AppleJuiceIzy/sony-a7iv-tec-version1/images/DSC08813.jpg

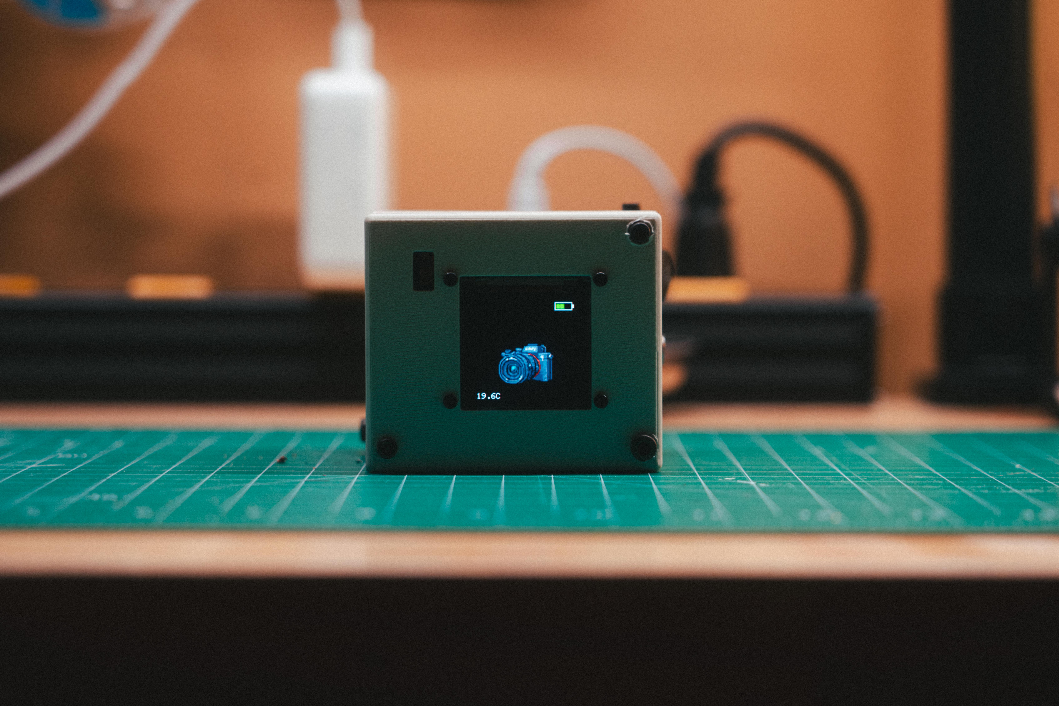
images/DSC08813.jpg
