AppleJuiceIzy/sony-a7iv-tec-version1/images/DSC08828.jpg

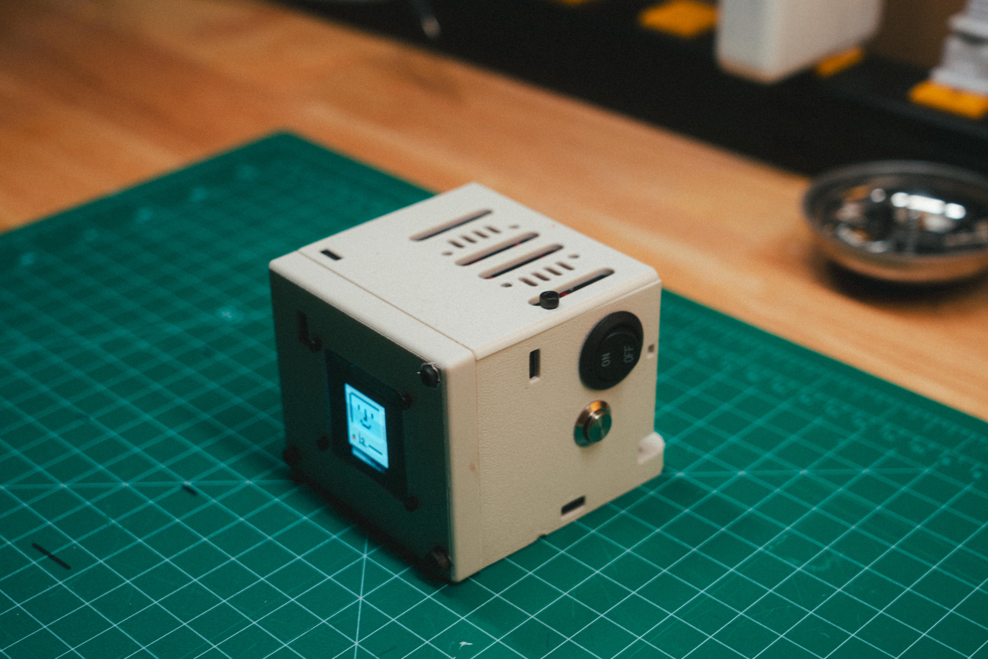
images/DSC08828.jpg
