AppleJuiceIzy/sony-a7iv-tec-version1/images/DSC08830.jpg

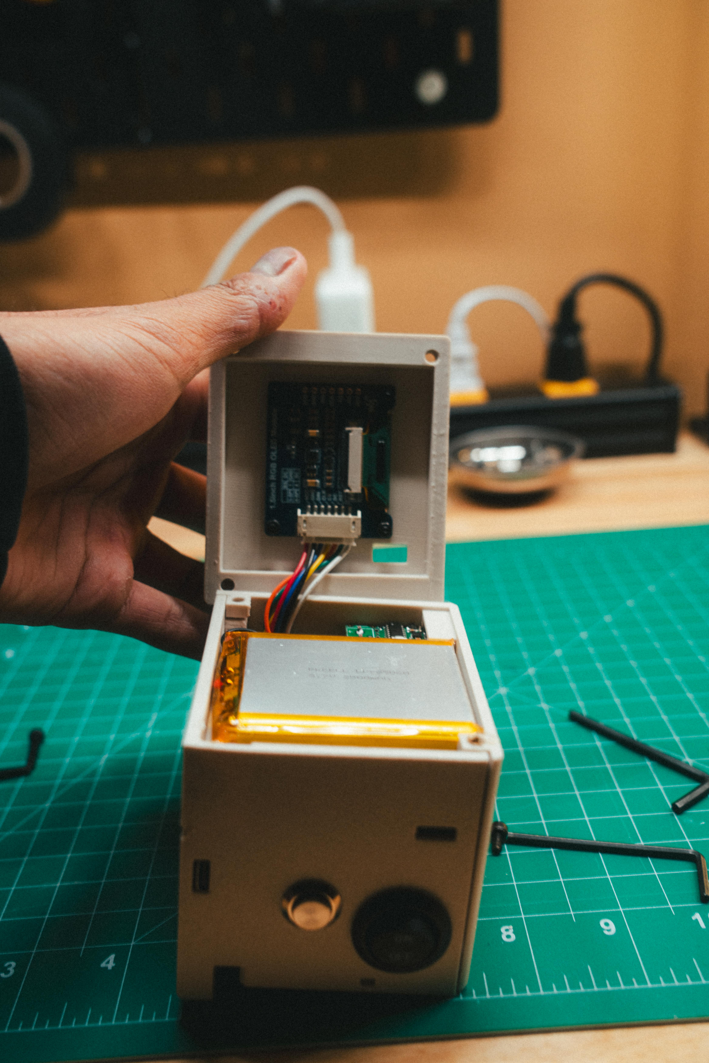
images/DSC08830.jpg
