AppleJuiceIzy/sony-a7iv-tec-version1/images/DSC08838.jpg

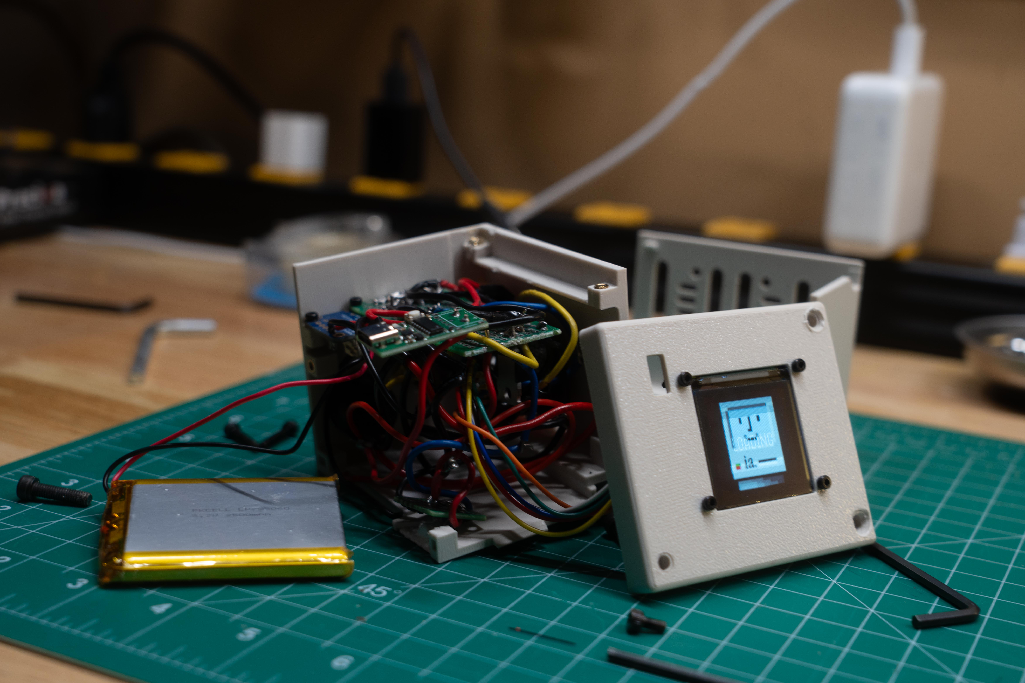
images/DSC08838.jpg
