AppleJuiceIzy/sony-a7iv-tec-version1/images/DSC08841.jpg

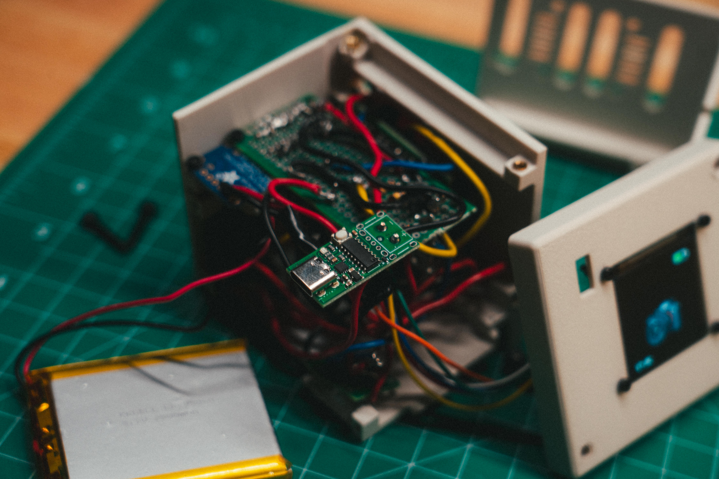
images/DSC08841.jpg
