AppleJuiceIzy/sony-a7iv-tec-version1/images/DSC08843.jpg

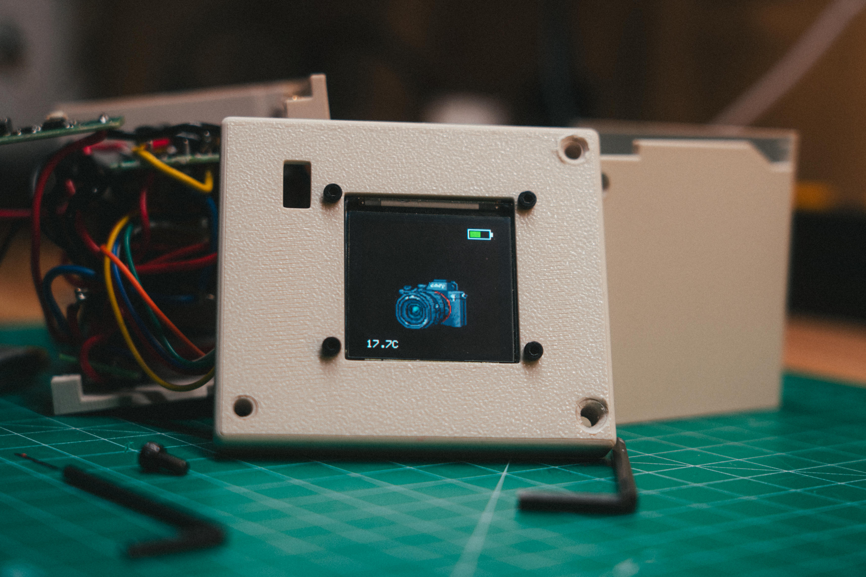
images/DSC08843.jpg
