AppleJuiceIzy/sony-a7iv-tec-version1/images/DSC08848.jpg

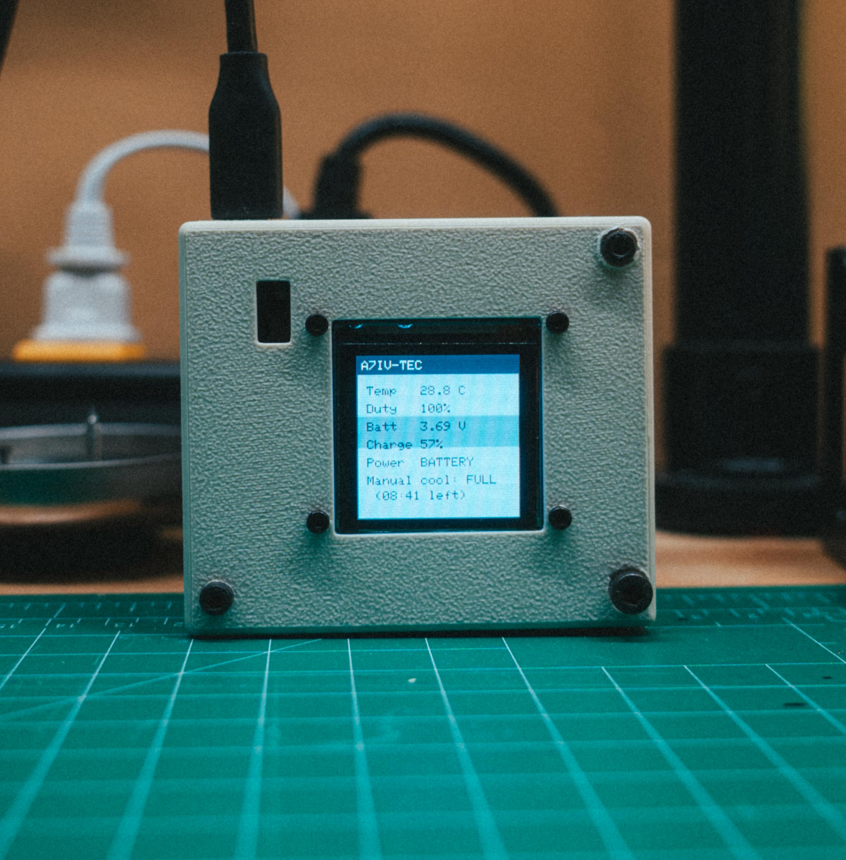
images/DSC08848.jpg
