AppleJuiceIzy/sony-a7iv-tec-version1/images/mounted_on_camera_2.jpg

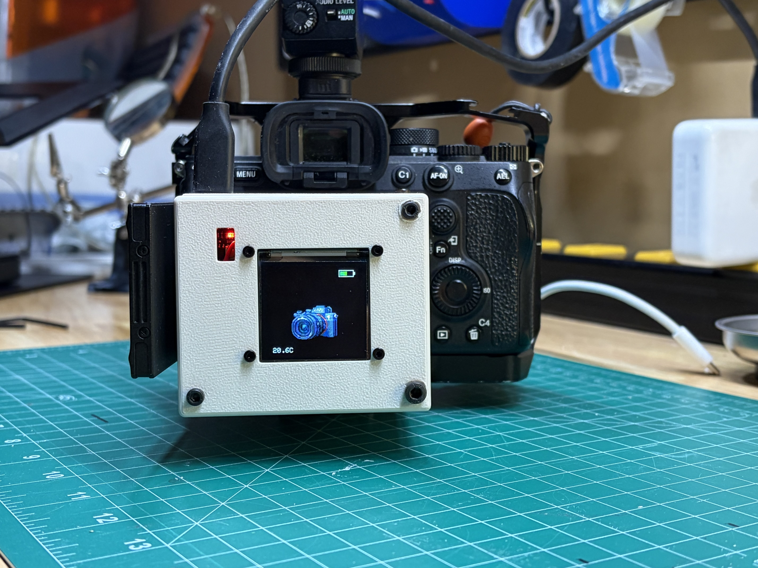
images/mounted_on_camera_2.jpg
