AppleJuiceIzy/sony-a7iv-tec-version1/CAD files/screen final enclosure v1.stl

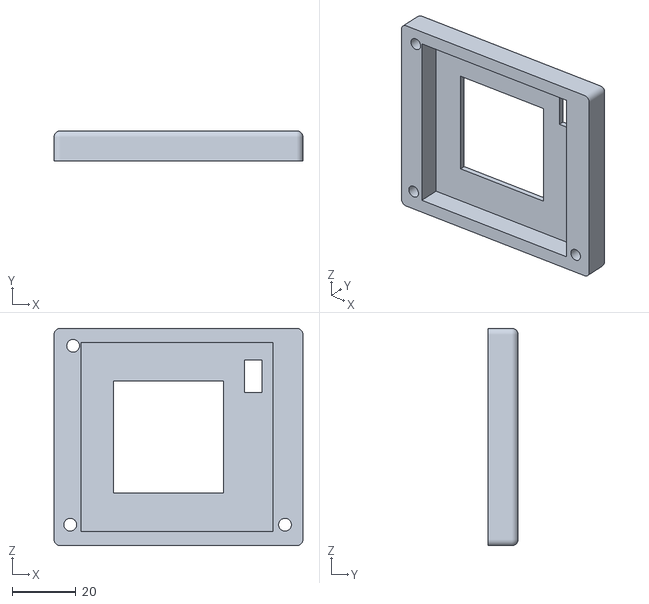
[picture p14: CAD file, 2026-10-14]
CAD files/screen final enclosure v1.stl
78.2 x 9.50 x 68.3
