AppleJuiceIzy/sony-a7iv-tec-version1/CAD files/fan side v4.stl

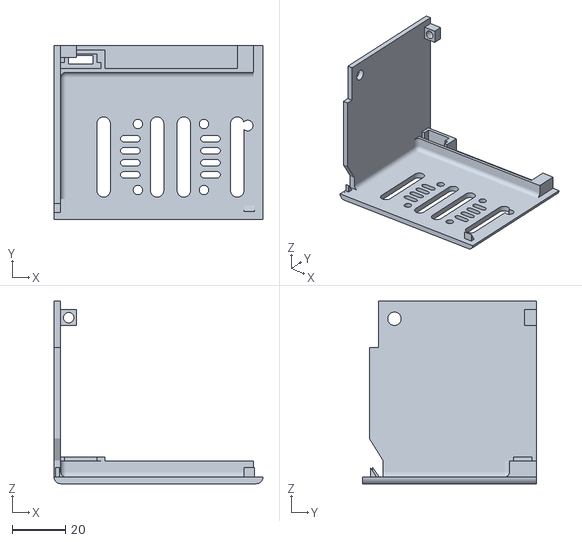
[picture p15: CAD file, 2026-10-14]
CAD files/fan side v4.stl
78.2 x 65.0 x 68.3
