AppleJuiceIzy/sony-a7iv-tec-version1/CAD files/chassis v10.stl

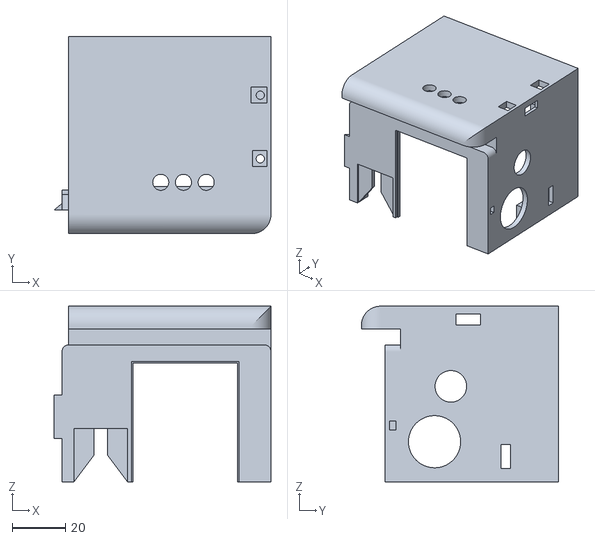
[picture p16: CAD file, 2026-10-14]
CAD files/chassis v10.stl
81.2 x 73.8 x 65.7
