AppleJuiceIzy/sony-a7iv-tec-version1/(commit log)

2026-08-18 Initial commit: firmware, wiring docs, BOM
2026-10-13 Add stats page, manual cooling, and animated logo intro
    - Cap Peltier duty at DUTY_MAX (80%) for the 12V TEC on the 15V PD supply
    - Add Mac-style stats page via GPIO27 single press or serial 'page'
    - Add manual cooling at full duty via double press or serial 'cool', with
    10-minute auto-off, MAN indicator and stats readout
    - Hold ANIM_HOT for at least 6s; smooth battery ADC with 32 samples + EMA
    - Scale the boot logo 1.00x to 1.20x across its 3500ms hold, bilinear and eased
    - Rotate the panel 180 degrees via SSD1351 hardware remap
    - Add tools/png2sprites.py to regenerate sprites.h from art/
2026-10-14 Update README.md
    add schematic
2026-10-14 create CAD files
